UltimateHackingKeyboard/uhk60v2-electronics/README.md

Ultimate Hacking Keyboard electronics
=====================================

Contained are the schematics and board layout KiCad files for the [Ultimate Hacking Keyboard](https://ultimatehackingkeyboard.com/), the UHK 60 v2 in specific.

Please make sure to clone this repo with:

`git clone --recursive git@github.com:UltimateHackingKeyboard/uhk60v2-electronics.git`

Now, you should be able to open any of the [KiCad](http://kicad-pcb.org/) projects of the repo:

* [left-main](left-main) contains main PCB of left keyboard half.
* [right-main](right-main) contains the main PCB of the right keyboard half.
* [display](display) contains the PCB that interfaces our custom manufactured LED segment display with the left main PCB.
