UltimateHackingKeyboard/uhk60v2-electronics/right-main/right-main.pdf

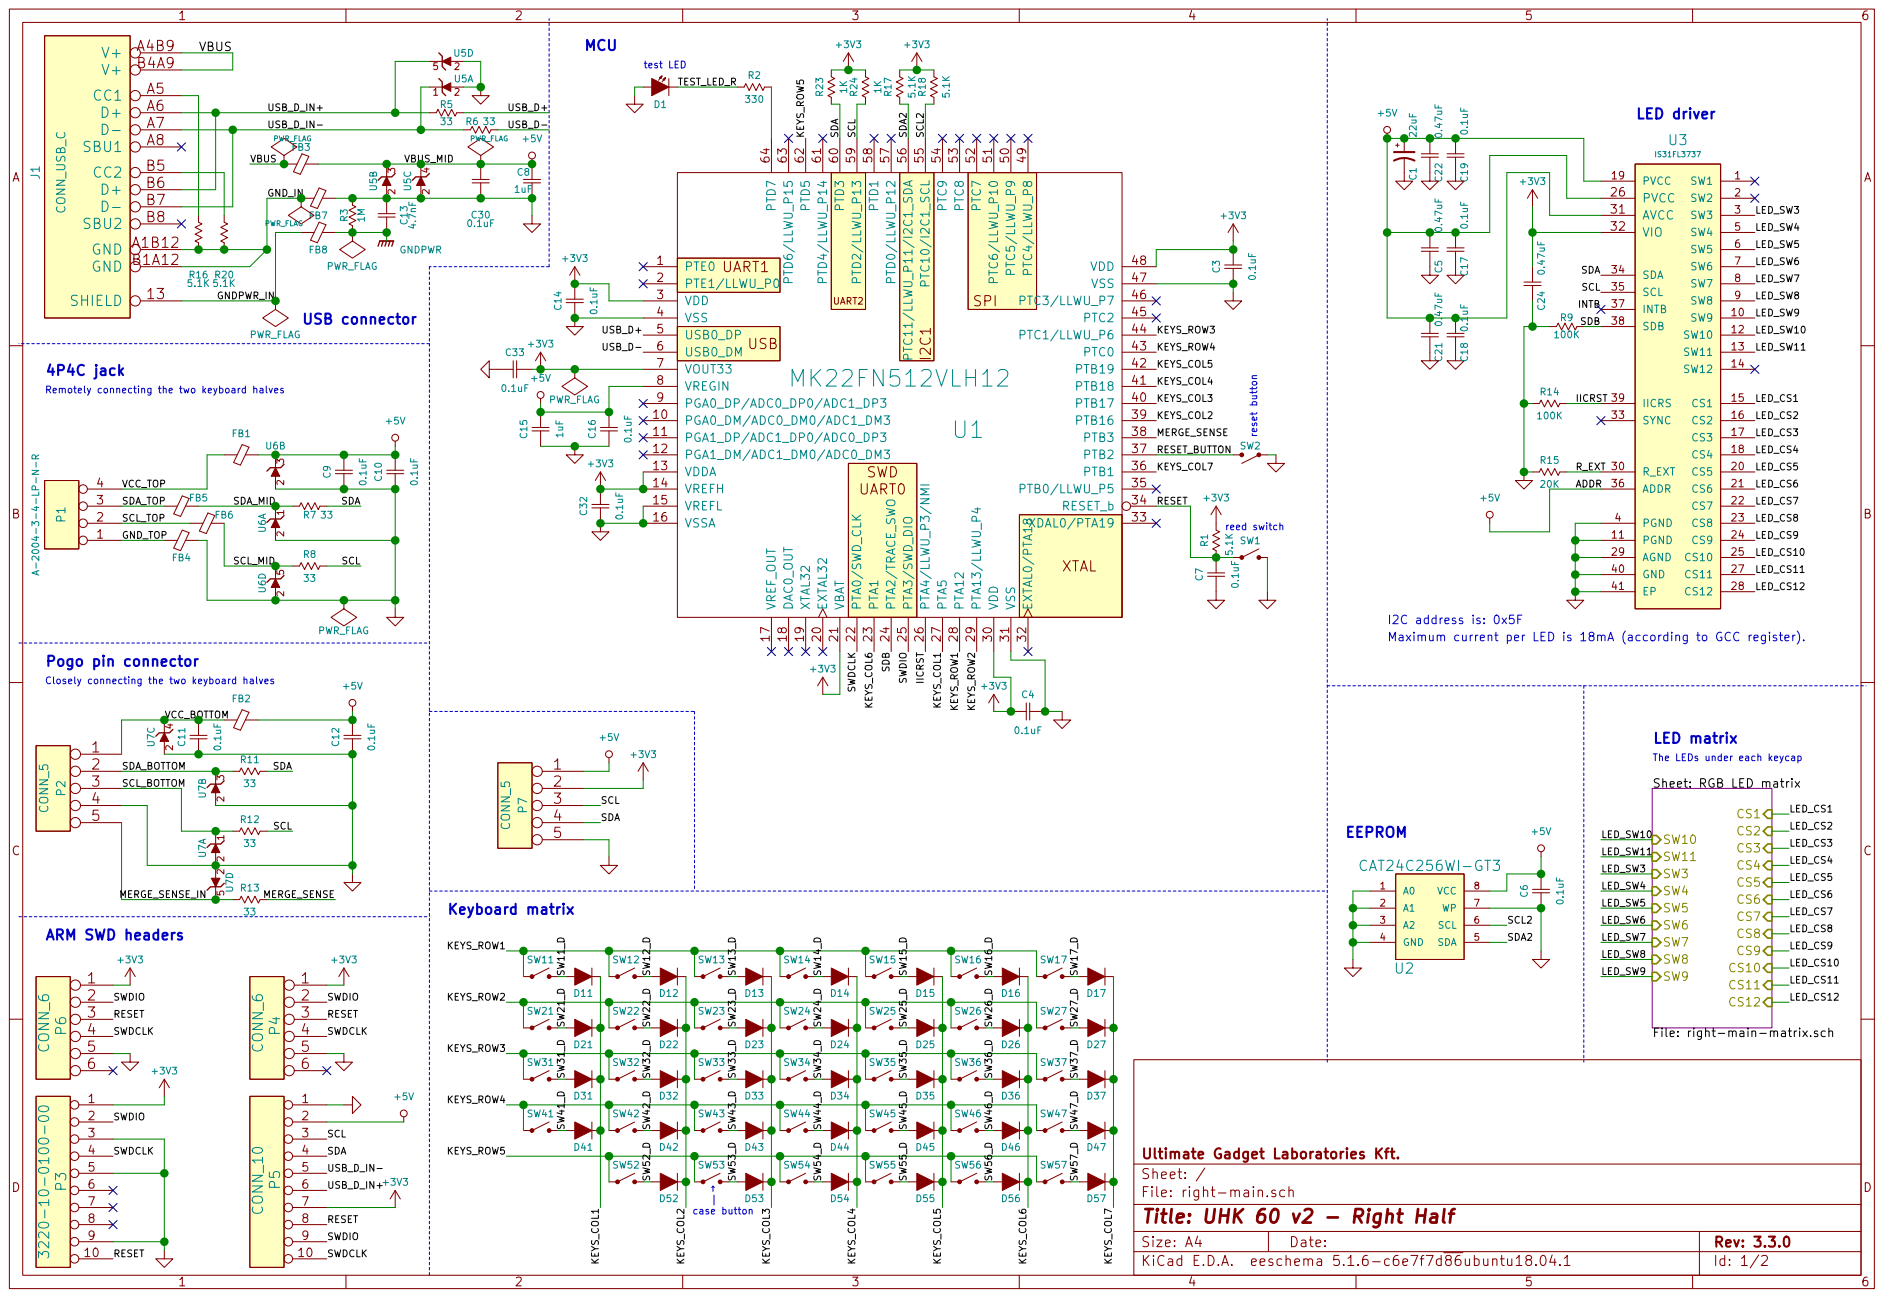
[picture p1: page 1]

The LEDs under each keycap MCU

LED driver LED matrix Maximum current per LED is 18mA (according to GCC register).

Closely connecting the two keyboard halves 4P4C jack

Id: 1/2 Title: UHK 60 v2 - Right Half
