UltimateHackingKeyboard/uhk60v2-electronics/left-main/left-main.pdf

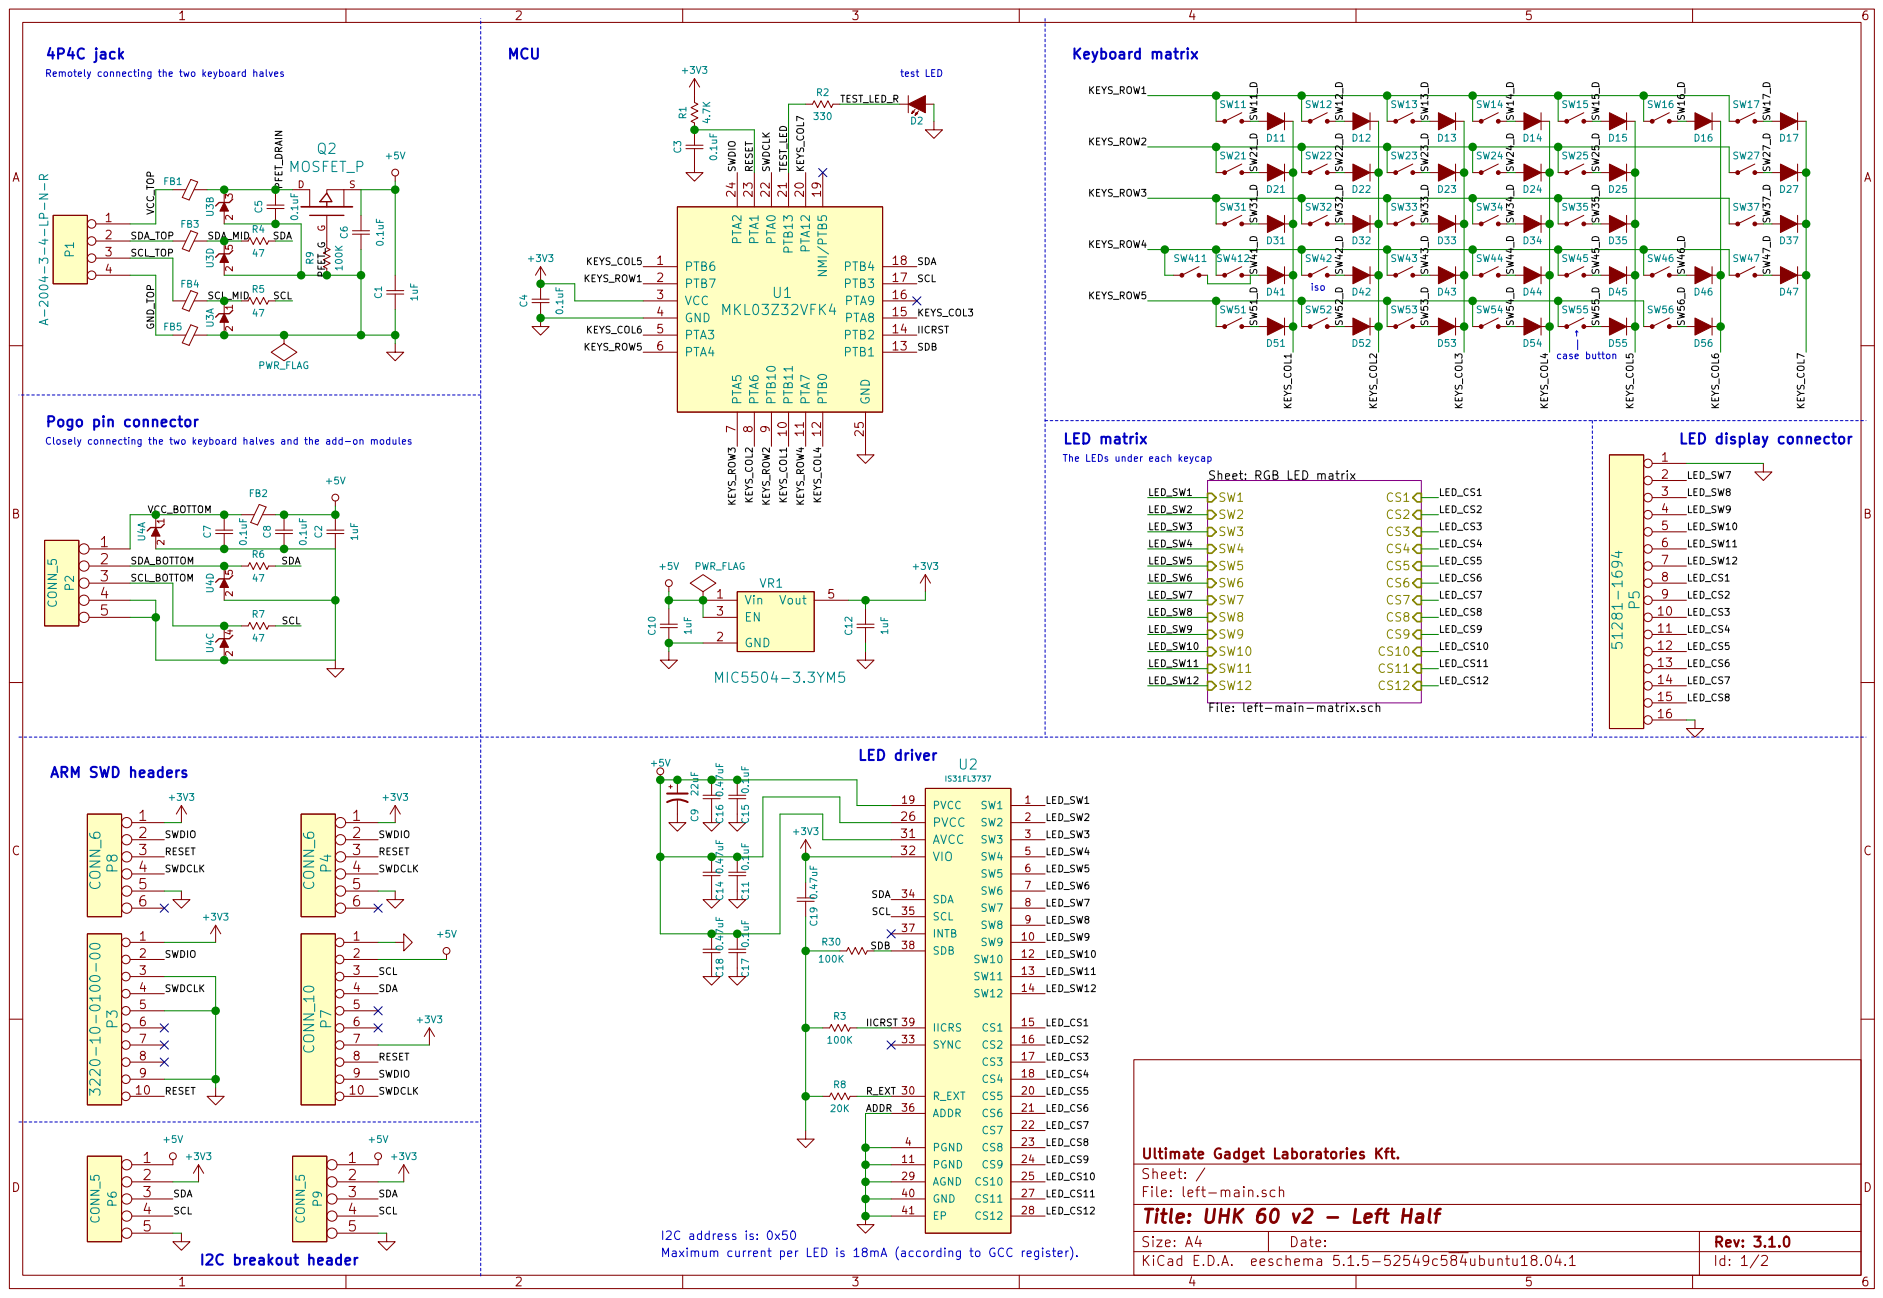
[picture p2: page 1]

The LEDs under each keycap MCU

iso Maximum current per LED is 18mA (according to GCC register). I2C breakout header

Id: 1/2 Title: UHK 60 v2 - Left Half File: left-main.sch Sheet: / Ultimate Gadget Laboratories Kft.
