UltimateHackingKeyboard/uhk60v2-electronics/(commit log)

2018-09-06 Update the submodule URL of the ugl-kicad-lib repo.
2018-09-06 Refer to the latest revision of ugl-kicad-lib.
2018-09-06 Add left-main-matrix.sch and update left-main.sch
    [left-main-matrix.sch]
2018-09-07 Change MX buttons to socket.
    [left-main-matrix.sch, left-main.sch]
2018-09-07 Change MX buttons to sockets on right side too.
    [right-main.sch]
2018-09-07 Add RGB LED matrix to right side.
    [right-main-matrix.sch, right-main.sch]
2018-09-07 Change LED driver to IS31FL3737.
    [right-main.sch]
2018-09-07 Change USB connector to USB type C.
    [right-main.sch]
2018-09-07 Set I2C address of LED driver.
    [left-main.sch, right-main.sch]
2018-09-07 Set footprints of RGB leds on both sides.
    [left-main-matrix.sch, right-main-matrix.sch]
2018-09-22 Add mandatory layers.
    [display.kicad_pcb, left-main.kicad_pcb, right-main.kicad_pcb]
2018-09-22 Update left board contour.
    [left-main.kicad_pcb]
2018-09-22 Update the contour of the right board.
    [right-main.kicad_pcb]
2018-09-22 Update the keepout areas of the left board.
    [left-main.kicad_pcb]
2018-09-22 Update the keepout areas of the right board.
    [right-main.kicad_pcb]
2018-09-22 Add circles to mark the positions of the LEDs of the left board.
    [left-main.kicad_pcb]
2018-09-22 Add circles to mark the positions of the LEDs of the right board.
    [right-main.kicad_pcb]
2018-09-22 Remove the top screw hole and related silk screen on the left and right boards.
    [left-main.kicad_pcb, right-main.kicad_pcb]
2018-09-22 Reposition the USB connector.
    [right-main.kicad_pcb]
2018-10-12 Fix schematic errors (error checker) on left side.
    [left-main-matrix.sch, left-main.sch]
2018-10-12 Update pcb with new components and set new positions of LEDs.
    [left-main.kicad_pcb]
2018-10-12 Update P7 swd header on left side.
    [left-main.sch]
2018-10-12 Revert "Update P7 swd header on left side."
    This reverts commit f23190d8810373420e60e62817cb1d523171376d.
    [left-main.sch]
2018-10-17 Change footprint of buttons to new hybrid type.
    [left-main.sch]
2018-10-17 Add footprint to LED driver and programming header, PCB update.
    [left-main.kicad_pcb, left-main.sch]
2018-10-17 The footprints of special buttons modified.
    [left-main.sch]
2018-10-17 Footprints position settings and a little wiring on left side.
    [left-main.kicad_pcb]
2018-10-19 Sockets repositioned.
    [left-main.kicad_pcb]
2018-10-26 Wiring on left side.
    [left-main.kicad_pcb, left-main.sch]
2018-10-28 Remove PWM test point from left side schematic.
    [left-main.sch]
2018-10-28 Change LED positions in matrix on left side.
    [left-main-matrix.sch]
2018-11-01 LED matrix pin order changed. PCB wiring on left side.
    [left-main-matrix.sch, left-main.kicad_pcb, left-main.sch]
2018-11-06 Change LED positions in matrix on left side and wiring on pcb.
    [left-main-matrix.sch, left-main.kicad_pcb]
2018-11-23 Remove capacitors. (Left)
    [left-main.sch]
2018-11-23 Rename testpoints and nets.
    [left-main.sch]
2018-11-23 Wiring on left side and fix silkscreen positions.
    [left-main.kicad_pcb]
2018-11-23 First final version of left side pcb.
    [left-main.kicad_pcb]
2018-11-27 Add power flag to +3V3.
    [left-main.sch]
2018-11-27 PCB check. (everything ok)
    [left-main.kicad_pcb]
2018-11-27 Mod. page settings parameters on sch. and pcb (version numbers, titles).
    [left-main-matrix.sch, left-main.kicad_pcb, left-main.sch]
2018-11-28 Remove DNP capacitors. Change LED driver net names.
    [left-main.sch]
2018-11-28 Change positions of designator on Silkscreen. Repos. FID3. Remove DNP caps.
    [left-main.kicad_pcb]
2018-12-03 Set footprints on right side schematic. (led driver, usb c)
    [right-main.sch]
2018-12-03 Update right side pcb according to schematic.
    [right-main.kicad_pcb]
2018-12-03 New type of pogo pin on left side.
    [left-main.kicad_pcb, left-main.sch]
2018-12-04 Add missing net names on left side.
    [left-main.kicad_pcb, left-main.sch]
2018-12-04 Necessary schematic modifications on right side.
    [right-main.sch]
2018-12-04 Refresh pcb with new footprints. Positions of new type of LEDs changed.
    [right-main.kicad_pcb]
2018-12-04 Set USB_C position.
    [right-main.kicad_pcb]
2018-12-10 Change socket footprints to hybrid type.
    [right-main.sch]
2018-12-10 Positions of RGB LEDs in matrix changed.
    [right-main-matrix.sch]
2018-12-10 Wiring on right side.
    [right-main.kicad_pcb]
2018-12-14 Reposition LEDs in matrix.
    [right-main-matrix.sch]
2018-12-14 Change driving lines of LED matrix.
    [right-main-matrix.sch, right-main.sch]
2018-12-14 Remove capacitor.
    [right-main.sch]
2018-12-14 Wiring on right side. (All connections are complete.)
    [right-main.kicad_pcb]
2018-12-16 Rotate D147 on right side.
    [right-main.kicad_pcb]
2018-12-16 10mm GND pad placed on left side pcb near UHK logo.
    [left-main.kicad_pcb]
2018-12-17 Update PCB with new 10mm GND pad footprint.
    [left-main.kicad_pcb]
2018-12-17 Add special socket footprint to button 7 on right side.
    [right-main.kicad_pcb, right-main.sch]
2018-12-17 Add fiducials on right side.
    [right-main.kicad_pcb]
2018-12-17 First final version of right side pcb.
    [right-main.kicad_pcb]
2018-12-18 Reposition tag connect on right side.
    [left-main.kicad_pcb, right-main.kicad_pcb]
2018-12-18 Channge tag connect position on left side pcb.
    [left-main.kicad_pcb]
2018-12-18 Optimized I2C paths on right side.
    [right-main.kicad_pcb]
2018-12-19 Fix FFC connector type in schematic on left side.
    [left-main.sch]
2018-12-19 New display board (update schematic and pcb).
    [display.kicad_pcb, display.sch]
2018-12-19 Wired display board.
    [display.kicad_pcb, display.sch]
2018-12-19 Add GND plane on display pcb.
    [display.kicad_pcb]
2018-12-19 Extended GND plane on right side pcb.
    [right-main.kicad_pcb]
2018-12-20 Update pogo connectors.
    [left-main.kicad_pcb, left-main.sch, right-main.kicad_pcb, right-main.sch]
2018-12-20 Fix errors. Add missing GND pad on left side. Displacement fiducial on right side.
    [left-main.kicad_pcb, right-main.kicad_pcb]
2018-12-20 DRC error fixed on display board.
    [display.kicad_pcb]
2018-12-30 USB C errors are solved. (Symbol, footprint, schematic, pcb)
    [right-main.kicad_pcb, right-main.sch]
2018-12-30 Collisions removed between test points and socket (left and right pcb).
    [left-main.kicad_pcb, right-main.kicad_pcb]
2018-12-30 Collisions removed between designator (silkscreen) and vias/pads.
    [left-main.kicad_pcb, right-main.kicad_pcb]
2018-12-30 Position of tag-connect changed.
    [left-main.kicad_pcb]
2018-12-30 Display FFC pinout changed.
    [display.kicad_pcb, display.sch, left-main.kicad_pcb, left-main.sch]
2019-01-13 Updated Cmts.User layers on left and right pcb.
    [left-main.kicad_pcb, right-main.kicad_pcb]
2019-01-14 Modified wiring on right side (panelize)
    [right-main.kicad_pcb]
2019-01-28 Change values of R23 and R24 to 1k on right side.
    [right-main.sch]
2019-01-28 Place text and logo onto silkscreen layer.
    [left-main.kicad_pcb, right-main.kicad_pcb]
2019-01-28 Change footrpints of 0.1uF capacitors to 0603.
    [left-main.kicad_pcb, left-main.sch, right-main.kicad_pcb, right-main.sch]
2019-01-30 Add 2x3 tag connectors to both side.
    [left-main.kicad_pcb, left-main.sch, right-main.kicad_pcb, right-main.sch]
2019-01-30 Flip USB C connector to the back side of right board.
    [right-main.kicad_pcb]
2019-02-08 Modified wiring on left side (panelize)
    [left-main.kicad_pcb]
2019-02-19 Recommended parts of LED driver added on left side.
    [left-main.kicad_pcb, left-main.sch]
2019-02-19 Recommended parts of LED driver added on right side.
    [left-main.kicad_pcb, right-main.kicad_pcb, right-main.sch]
2019-02-19 Updated footprints on both side (silkscreen mods).
    [left-main.kicad_pcb, right-main.kicad_pcb]
2019-02-19 Recommended parts of LED driver added on both side (0.47uF).
    [left-main.kicad_pcb, left-main.sch, right-main.kicad_pcb, right-main.sch]
2019-02-26 Reposition bridges.
    [right-main.kicad_pcb]
2019-03-05 Library update. Updated silkscreen layers on both sides.
    [left-main.kicad_pcb, right-main.kicad_pcb]
2019-03-10 Library update and use new footprints on boards. Wiring on left side.
    [left-main.sch, right-main.kicad_pcb]
2019-03-12 Remove some DRC errors.
    [left-main.kicad_pcb]
2019-03-22 Wiring on left side (almost complete).
    [left-main.kicad_pcb]
2019-03-22 Zone update on left side.
    [left-main.kicad_pcb]
2019-03-22 Add resistors to USB-C section.
    [right-main.sch]
2019-03-22 Update footprints, edge cuts and keepout (Eco1) layers on right side.
    [right-main.kicad_pcb]
2019-03-22 Add new margin layer to right side.
    [right-main.kicad_pcb]
2019-03-26 Rotated sockets and LEDs on right side.
    [right-main.kicad_pcb]
2019-04-09 Change footprint of button 7 on right side.
    [right-main.sch]
2019-04-09 Change footprint of USB C resistors.
    [right-main.sch]
2019-04-09 Completed wiring on right side.
    [right-main.kicad_pcb]
2019-04-09 Update EEPROM footprint on right side.
    [right-main.kicad_pcb]
2019-04-09 New voltage regulator on left side.
    [left-main.kicad_pcb, left-main.sch]
2019-04-09 5 pin ffc on left side added.
    [left-main.kicad_pcb, left-main.sch]
2019-04-09 Wiring on right side. New ffc added.
    [right-main.kicad_pcb, right-main.sch]
2019-04-12 USB lines are connected to repositioned JTAG connector.
    [right-main.kicad_pcb, right-main.sch]
2019-04-12 Updated socket footprints on both sides.
    [left-main.kicad_pcb, right-main.kicad_pcb]
2019-04-12 ERC fix on left schematic.
    [left-main.sch]
2019-04-12 Use dedicated footprint on right side near FFC connector (collision).
    [right-main.sch]
2019-04-12 Completed silkscreen layers.
    [left-main.kicad_pcb, right-main.kicad_pcb]
2019-04-14 Library update (TH footprints)
    [display.kicad_pcb, left-main.kicad_pcb, right-main.kicad_pcb]
2019-04-14 Wiring on right side. (panelizer)
    [right-main.kicad_pcb]
2019-04-14 Wiring on left side. (panelizer)
    [left-main.kicad_pcb]
2019-04-14 Modified outline bridges on left side.
    [left-main.kicad_pcb]
2019-04-15 Outline bridges removed from display board.
    [display.kicad_pcb]
2019-04-15 Add readme for the pogo pin min distance script.
2019-04-15 Edit B.Paste layers.
    [left-main.kicad_pcb, right-main.kicad_pcb]
2019-04-16 Updated Edge.Cuts layers on both side.
    [left-main.kicad_pcb, right-main.kicad_pcb]
2019-04-25 Increased power tracks on left and right pcb.
    [left-main.kicad_pcb, right-main.kicad_pcb]
2019-04-26 LED driver Vccio changed.
    [left-main.kicad_pcb, left-main.sch, right-main.kicad_pcb, right-main.sch]
2019-05-03 LED driver connections changed.
    [left-main.kicad_pcb, left-main.sch, right-main.kicad_pcb, right-main.sch]
2019-05-05 Add front-side RGB LED silk screen for showing orientation.
    [left-main.kicad_pcb, right-main.kicad_pcb]
2019-05-05 Improve silk screen.
    [display.kicad_pcb, display.sch, left-main.kicad_pcb, left-main.sch, right-main.kicad_pcb, right-main.sch]
2019-05-05 Update pogo pin footprints and improve silk screen.
    [display.kicad_pcb, left-main.kicad_pcb, right-main.kicad_pcb]
2019-05-05 Improve silk screen and move around test points.
    [display.kicad_pcb, left-main.kicad_pcb, right-main.kicad_pcb]
2019-05-05 Update silk screen and adjust test point positions.
    [left-main.kicad_pcb, right-main.kicad_pcb]
2019-05-05 Improve silk screen and adjust test point positions.
    [left-main.kicad_pcb, right-main.kicad_pcb]
2019-05-06 Modified tracks on bridges.
    [left-main.kicad_pcb, right-main.kicad_pcb]
2019-05-07 Track width decreased on bridges.
    [left-main.kicad_pcb, right-main.kicad_pcb]
2019-05-14 Make fiducials, reed switches and programming headers virtual.
    [display.kicad_pcb, left-main.kicad_pcb, right-main.kicad_pcb]
2019-05-14 Make test LED parts virtual.
    [left-main.kicad_pcb, right-main.kicad_pcb]
2019-05-14 Set the value of D111 to VAL**, just like all the other SMD RGB LEDs.
    [right-main.kicad_pcb]
2019-05-14 Mark unused 10uF caps virtual.
    [left-main.kicad_pcb, right-main.kicad_pcb]
2019-05-15 Make the "Model: UHK 60 v2 | PCB ID: uhk60v2_left_2.0.0" text slightly larger.
    [left-main.kicad_pcb]
2019-07-15 Modify tag connect pinout on both side.
    [left-main.kicad_pcb, left-main.sch, right-main.kicad_pcb, right-main.sch]
2019-08-06 Update rgb led footprints and remove unneccessary components.
    [left-main.kicad_pcb, right-main.kicad_pcb, right-main.sch]
2019-08-06 Change orientation of sockets.
    [left-main.kicad_pcb, right-main.kicad_pcb]
2019-08-06 Rotate rgb leds.
    [left-main.kicad_pcb]
2019-08-06 Update pcbs with modified rgb led footrpint.
    [left-main.kicad_pcb, right-main.kicad_pcb]
2019-08-06 Fix contour on both pcb.
    [left-main.kicad_pcb, right-main.kicad_pcb]
2019-08-06 Remove ADC circuit on right side.
    [right-main.kicad_pcb, right-main.sch]
2019-08-07 Ignore generated BOM. Update UGL lib.
2019-08-09 Update right FFC connector footprint.
    [right-main.kicad_pcb]
2019-08-09 Update FFC connectors. Resolve DRC errors.
    [left-main.kicad_pcb]
2019-08-10 Remove the shield ring from the right half as it can't be placed.
    [right-main-matrix.sch, right-main.kicad_pcb, right-main.sch]
2019-08-10 Resolve DRC errors by not crossing board edges with tracks.
    [left-main.kicad_pcb, right-main.kicad_pcb]
2019-08-10 Put the RGB LED footprints of the right half to the bottom side.
    [right-main-matrix.sch, right-main.kicad_pcb]
2019-08-10 Put the RGB LEDs of the left half on the bottom side.
    [left-main.kicad_pcb]
2019-08-10 Update RGB LED values.
    [left-main.kicad_pcb]
2019-08-10 Remove margin layer artifacts.
    [left-main.kicad_pcb, right-main.kicad_pcb]
2019-08-11 Update contours and library reference.
    [left-main.kicad_pcb, right-main.kicad_pcb]
2019-08-11 Change 0805 footrpints to 0603.
    [left-main.kicad_pcb, left-main.sch, right-main.kicad_pcb, right-main.sch]
2019-08-11 Visible values on silkscreen layers.
    [left-main.kicad_pcb, left-main.sch, right-main.kicad_pcb, right-main.sch]
2019-08-11 Change bridge position on right pcb.
    [right-main.kicad_pcb]
2019-08-12 Update LED footprints.
    [left-main.kicad_pcb, right-main.kicad_pcb]
2019-08-13 Remove test points.
    [display.kicad_pcb, display.sch, left-main-matrix.sch, left-main.kicad_pcb, left-main.sch, right-main.kicad_pcb, right-main.sch]
2019-08-13 Revert test point changes.
    [display.kicad_pcb, display.sch, left-main-matrix.sch, left-main.kicad_pcb, left-main.sch, right-main.kicad_pcb, right-main.sch]
2019-08-14 Fix right half contour.
    [right-main.kicad_pcb]
2019-08-14 Fix left half contour.
    [left-main.kicad_pcb]
2019-08-14 Remove connector boards.
    [connectors.kicad_pcb, connectors.sch]
2019-08-14 Add key labels on the right half as text items.
    [right-main.kicad_pcb]
2019-08-14 Put socket modules to the back side on the right half.
    [right-main.kicad_pcb]
2019-08-14 Change socket values to S01_Socket.
    [right-main.kicad_pcb, right-main.sch]
2019-08-15 Adjust the positioning of hidden values and unhide some of them on the right half.
    [right-main.kicad_pcb]
2019-08-15 Improve the silk screen of the right half.
    [right-main.kicad_pcb]
2019-08-15 Improve right half silk screen.
    [right-main.kicad_pcb]
2019-08-15 Add UHK logos on the left and right halves.
    [left-main.kicad_pcb, right-main.kicad_pcb]
2019-08-16 Make pogo pin connectors through-hole and make logos virtual.
    [left-main.kicad_pcb, right-main.kicad_pcb]
2019-08-17 Update a bunch of components to remove their technical silk screen layers.
    [left-main.kicad_pcb, right-main.kicad_pcb]
2019-08-17 Update components to remove technical silk screen layers.
    [right-main.kicad_pcb]
2019-08-17 Update components to remove silk screen from technical layers.
    [left-main.kicad_pcb]
2019-08-17 Add front facing silk sceen text for the key letters of the right half.
    [right-main.kicad_pcb]
2019-08-17 Add separate key texts on the back side of the left board.
    [left-main.kicad_pcb]
2019-08-17 Reposition the FFC connector of the display board.
    [display.kicad_pcb]
2019-08-17 Interconnect display GND pads.
    [display.kicad_pcb]
2019-08-17 Update silk screen.
    [display.kicad_pcb]
2019-08-17 Reposition the FFC connector of the LED display on the left board.
    [left-main.kicad_pcb]
2019-08-17 Adjust tracks a bit.
    [left-main.kicad_pcb]
2019-08-17 Update and flip S01_Hybrid_Socket modules.
    [left-main.kicad_pcb]
2019-08-17 Change left side socket values to S01_Socket.
    [left-main.kicad_pcb, left-main.sch]
2019-08-18 Update S01_Hybrid_Socket_Left_Pin and S01_Hybrid_Socket_Right_Pin modules.
    [left-main.kicad_pcb]
2019-08-18 Update S01_Hybrid_Socket_ANSI_Shift_InverseSlotHole.
    [left-main.kicad_pcb]
2019-08-18 Update switch values of the left half.
    [left-main.kicad_pcb, right-main.kicad_pcb]
2019-08-18 Reposition S01_Socket and RGB_LED hidden values.
    [left-main.kicad_pcb]
2019-08-18 Flip SW* reference designators on the left half.
    [left-main.kicad_pcb]
2019-08-18 Reposition SW* and D* reference designators on the left half.
    [left-main.kicad_pcb]
2019-08-19 Add front side key texts for the left half.
    [left-main.kicad_pcb]
2019-08-19 Adjust font thicknesses.
    [left-main.kicad_pcb]
2019-08-19 Replace SOD-123 diodes with SOD-323 on the left half.
    [left-main.kicad_pcb, left-main.sch]
2019-08-19 Fix tracks now that the SOD-323 diodes have been placed.
    [left-main.kicad_pcb]
2019-08-19 Fix most of the routing for SOD-323 on the right half.
    [right-main.kicad_pcb, right-main.sch]
2019-08-19 Improve SOD-323 related rerouting on the right half.
    [right-main.kicad_pcb]
2019-08-19 Make DRC happy on the right half after the SOD-323 change.
    [right-main.kicad_pcb]
2019-08-19 Route 3 of the 4 D1411 tracks.
    [left-main-matrix.sch, left-main.kicad_pcb]
2019-08-19 Fully route tracks to D1411.
    [left-main.kicad_pcb]
2019-08-19 Connect ground all the way on the left half.
    [left-main.kicad_pcb]
2019-08-19 Replace 0806 test LEDs with 0603.
    [left-main.kicad_pcb, left-main.sch, right-main.kicad_pcb, right-main.sch]
2019-08-19 Improve silk screen on the right half.
    [right-main.kicad_pcb]
2019-08-20 Make test LEDs and their resistors virtual.
    [left-main.kicad_pcb, right-main.kicad_pcb]
2019-08-22 Put C11 and C14 much closer to the LED driver.
    [left-main.kicad_pcb]
2019-08-23 Exchange C11 and C14.
    [left-main.kicad_pcb]
2019-08-23 Remove fiducials.
    [left-main.kicad_pcb, right-main.kicad_pcb]
2019-08-23 Place C15 closer to the LED driver. Don't connect INTB on the left half.
    [left-main.kicad_pcb, left-main.sch]
2019-08-23 Put C16 closer to the LED driver.
    [left-main.kicad_pcb]
2019-08-23 Route caps closer to the LED driver.
    [left-main.kicad_pcb]
2019-08-23 Don't connect INTB on the right half either.
    [right-main.kicad_pcb, right-main.sch]
2019-08-24 Update left board outline based on CAD.
    [left-main.kicad_pcb]
2019-08-24 Update right board edge based on CAD.
    [right-main.kicad_pcb]
2019-08-24 Update the keepout areas of the right half.
    [right-main.kicad_pcb]
2019-08-24 Update left board keepout areas.
    [left-main.kicad_pcb]
2019-08-24 Move tracks farther from the edge.
    [display.kicad_pcb]
2019-08-24 Route outbound tracks as close as possible to breakout tabs.
    [left-main.kicad_pcb, right-main.kicad_pcb]
2019-08-24 Put tracks farther from the edge of the right board.
    [right-main.kicad_pcb]
2019-08-24 Route tracks farther from the edges on the left half.
    [left-main.kicad_pcb]
2019-08-24 Bump version number to 3.0.0
    [display.kicad_pcb, display.sch, left-main.kicad_pcb, left-main.sch, right-main.kicad_pcb, right-main.sch]
2019-08-24 Change version number on boards to 3.0.0
    [display.kicad_pcb, left-main.kicad_pcb, right-main.kicad_pcb]
2019-08-24 Rotate every LED in 180 degree orientation which can be rotated as such.
    [left-main.kicad_pcb, right-main.kicad_pcb]
2019-08-24 Move things out of the way of the keepout zones of the feet.
    [left-main.kicad_pcb, left-main.sch, right-main.kicad_pcb]
2019-08-25 Make the ground pour zones of the boards closely follow their outlines.
    [display.kicad_pcb, left-main.kicad_pcb, right-main.kicad_pcb]
2019-08-30 Change bayonet lock soft keepout area depths from 0.9 to 1.4 mm.
    [left-main.kicad_pcb, right-main.kicad_pcb]
2019-08-31 Add cutout above SW25 that must have been removed accidentally.
    [right-main.kicad_pcb]
2019-08-31 Put C4 closer to U1.
    [left-main.kicad_pcb]
2019-08-31 Don't put solder paste on the pads of the test LED regions.
    [left-main.kicad_pcb, right-main.kicad_pcb]
2019-08-31 Remove C13 from the left side.
    [left-main.kicad_pcb, left-main.sch]
2019-08-31 Remove C20 and C2 from the right half.
    [right-main.kicad_pcb, right-main.sch]
2019-08-31 Change the capacitance of tantalum caps from 10uF to 22uF.
    [left-main.kicad_pcb, left-main.sch, right-main.kicad_pcb, right-main.sch]
2019-08-31 Place C10 and C12 closer to VR1.
    [left-main.kicad_pcb]
2019-08-31 Put C20 closer to U2.
    [left-main.kicad_pcb]
2019-08-31 Clean up tracks.
    [left-main.kicad_pcb]
2019-08-31 Put C3 and R1 closer to U1.
    [left-main.kicad_pcb]
2019-08-31 Put R9 closer to the 4P4C block.
    [left-main.kicad_pcb]
2019-08-31 Place R1 and C3 a bit farther from D15.
    [left-main.kicad_pcb]
2019-08-31 Put components closer to the pogo pin connector.
    [left-main.kicad_pcb]
2019-08-31 Tweak silk screen.
    [left-main.kicad_pcb]
2019-08-31 Put C14, C15, C16, C33 closer to U1.
    [right-main.kicad_pcb]
2019-08-31 Put R5 and R6 closer to U1 and connect USB_D_IN[+-] to P5 instead of USB_D[+-].
    [right-main.kicad_pcb, right-main.sch]
2019-08-31 Put C6 closer to U2.
    [right-main.kicad_pcb]
2019-09-01 Move texts so that they don't interfere with other boards on the panel.
    [display.kicad_pcb, left-main.kicad_pcb, right-main.kicad_pcb]
2019-09-01 Add comma.
    [right-main.kicad_pcb]
2019-09-01 Update LED display module.
    [display.kicad_pcb]
2019-09-03 Fix the positions of pogo pin connectors.
    [left-main.kicad_pcb, right-main.kicad_pcb]
2019-10-29 Update diode and RGB LED modules.
    [left-main.kicad_pcb, right-main.kicad_pcb]
2019-10-29 Update keepout areas based on CAD.
    [right-main.kicad_pcb]
2019-10-29 Update right half contour according to CAD.
    [right-main.kicad_pcb]
2019-10-29 Update the ground pour of the right half according to the udpated contour.
    [right-main.kicad_pcb]
2019-10-30 Fix boss side position.
    [left-main.kicad_pcb]
2019-10-30 Update the keepout area of the left half based on CAD.
    [left-main.kicad_pcb]
2019-10-30 Update left contour based on CAD.
    [left-main.kicad_pcb]
2019-10-30 Update the zone of the left half based on the new contour.
    [left-main.kicad_pcb]
2019-10-31 Update the sockets of the 1st row of the right half.
    [right-main.kicad_pcb]
2019-10-31 Update sockets in the 2nd row of the right half.
    [right-main.kicad_pcb]
2019-10-31 Update the sockets of the 3rd row of the right half.
    [right-main.kicad_pcb]
2019-11-01 Update the sockets of the 4th row of the right half.
    [right-main.kicad_pcb]
2019-11-01 Update the sockets of the 5th row of the right half.
    [right-main.kicad_pcb]
2019-11-01 Fix the positions of the reference designators of the right half.
    [right-main.kicad_pcb]
2019-11-01 Move TC2060 header slightly farther from the pad of the nearby socket.
    [right-main.kicad_pcb]
2019-11-01 Make edge layer continuous. Update SW11 socket.
    [left-main.kicad_pcb]
2019-11-01 Update more sockets in the 1st row of the left UHK half.
    [left-main.kicad_pcb]
2019-11-01 Update most sockets in the 1st row of the left half except 2.
    [left-main.kicad_pcb]
2019-11-01 Update the sockets of the 2nd row of the left keyboard half.
    [left-main.kicad_pcb]
2019-11-02 Change the last switch of the 2nd row of the left half.
    [left-main.kicad_pcb]
2019-11-02 Change the sockets of the 3rd row of the left half.
    [left-main.kicad_pcb]
2019-11-02 Replace sockets of the 4th row of the left half with the exception of ANSI and ISO sockets.
    [left-main.kicad_pcb]
2019-11-02 Replace 3 sockets of the 5th row of the left half.
    [left-main.kicad_pcb]
2019-11-02 Replace one more socket in the 5th row of the left half.
    [left-main.kicad_pcb]
2019-11-02 Connect unconnected nets.
    [left-main.kicad_pcb]
2019-11-02 Change the last socket of the 5th row of the left half.
    [left-main.kicad_pcb]
2019-11-13 Update the SW12 socket.
    [left-main.kicad_pcb]
2019-11-13 Update SW13 socket.
    [left-main.kicad_pcb]
2019-11-13 Put the 22uF cap closer to the LED driver.
    [left-main.kicad_pcb]
2019-11-20 Update Omron switch modules.
    [left-main.kicad_pcb, right-main.kicad_pcb]
2019-11-20 Use the new left ISO socket module.
    [left-main.kicad_pcb]
2019-11-20 Update middle ISO socket.
    [left-main.kicad_pcb]
2019-11-20 Update Left ISO socket.
    [left-main.kicad_pcb]
2019-11-20 Use ISO right socket.
    [left-main.kicad_pcb]
2019-11-26 Move C4 way closer to the 30 and 31 pins of U1.
    [right-main.kicad_pcb]
2019-11-26 Add 3.3V zone below U1.
    [right-main.kicad_pcb]
2019-11-26 Put C32 closer to U1 and put C23 closer to U3.
    [right-main.kicad_pcb]
2019-11-26 Route GNDPWR near the USB connector better.
    [right-main.kicad_pcb]
2019-11-26 Add ferrite for GNDPWR.
    [right-main-matrix.sch, right-main.kicad_pcb, right-main.sch]
2019-11-26 Put caps closer to pin 19 of U3.
    [right-main.kicad_pcb]
2019-11-26 Make the position of C1, C22 and C19 more explicit on the schematic.
    [right-main.kicad_pcb, right-main.sch]
2019-11-26 Clarify the position of C5 and C17 on the schematic.
    [right-main.kicad_pcb, right-main.sch]
2019-11-26 Improve the placement of C19.
    [right-main.kicad_pcb]
2019-11-26 Improve the placement of C22.
    [right-main.kicad_pcb]
2019-11-26 Put caps closer to U3.
    [right-main.kicad_pcb, right-main.sch]
2019-11-26 Connect every net.
    [right-main.kicad_pcb]
2019-11-26 Put C14 closer to the U1.
    [right-main.kicad_pcb]
2019-11-26 Restore the position of C14 because it's contrained by keepout areas.
    [right-main.kicad_pcb]
2019-11-26 Import netlist.
    [right-main.kicad_pcb]
2019-11-26 Bring components closer to U3.
    [right-main.kicad_pcb]
2019-11-26 Simplify the routing of the 5V rail near the LED driver.
    [right-main.kicad_pcb]
2019-11-26 Simplify 5V rail routing.
    [right-main.kicad_pcb]
2019-11-26 Make schematics less crowded.
    [left-main-matrix.sch, left-main.sch, right-main.sch]
2019-11-27 Simplify the 5V rail of the right half which leads to the EEPROM and MCU.
    [right-main.kicad_pcb]
2019-11-27 Move U3 downward farther from keepout areas.
    [right-main.kicad_pcb]
2019-11-27 Update netlist to feature the correct ISO switch modules.
    [left-main.sch]
2019-11-27 Update left board based on netlist.
    [left-main.kicad_pcb]
2019-11-27 Update right board based on netlist.
    [right-main.kicad_pcb]
2019-11-27 Remove C20 from the left half because it was not needed for the LED driver.
    [left-main.kicad_pcb, left-main.sch]
2019-11-27 Make the silk screen of the right half look great.
    [right-main.kicad_pcb]
2019-11-28 Fix silk screen positions.
    [left-main.kicad_pcb]
2019-11-28 Exchange C5 and C17.
    [right-main.kicad_pcb]
2019-11-28 Make the schematic of the left half show where the capacitors of the LED driver should be placed.
    [left-main.sch, right-main.kicad_pcb]
2019-12-04 Change R_EXT to 20K on both halves.
    [left-main.kicad_pcb, left-main.sch, right-main.kicad_pcb, right-main.sch]
2019-12-04 Slightly reposition C18 and C21 on the schematic.
    [right-main.sch]
2019-12-23 Fix the silk screen position for C18 and C21 on the right half.
    [right-main.kicad_pcb]
2019-12-23 Make the test LED and its resistor virtual on the left half.
    [left-main.kicad_pcb]
2019-12-23 Show reset pins on the back of the left and right boards.
    [left-main.kicad_pcb, right-main.kicad_pcb]
2019-12-23 Update some processors modules to make their orientation marker easier to see.
    [left-main.kicad_pcb, right-main.kicad_pcb]
2019-12-23 Change the silk screen text of the ISO key to ISO instead of \
    [left-main.kicad_pcb]
2019-12-23 Rotate key texts on the back side of the boards according to the angles of sockets.
    [left-main.kicad_pcb, right-main.kicad_pcb]
2019-12-23 Update FFC connector on the display board.
    [display.kicad_pcb]
2019-12-24 Reposition reference designator.
    [left-main.kicad_pcb]
2019-12-24 Make the silk screen of test LED sections nicer.
    [left-main.kicad_pcb, right-main.kicad_pcb]
2019-12-24 Move the test LED closer to the edge of the left board.
    [left-main.kicad_pcb]
2019-12-26 Update SS-01D switches to feature the pin plunger on the silk screen.
    [left-main.kicad_pcb, right-main.kicad_pcb]
2019-12-26 Put silk screen texts closer to their relevant sockets.
    [left-main.kicad_pcb, right-main.kicad_pcb]
2019-12-26 Change the orientation of P6.
    [right-main.kicad_pcb]
2019-12-26 Change the orientation and position of P5.
    [right-main.kicad_pcb]
2019-12-26 Bump version to 3.1.0
    [display.kicad_pcb, display.sch, left-main.kicad_pcb, left-main.sch, right-main.kicad_pcb, right-main.sch]
2019-12-26 Resolve ERC errors.
    [right-main.sch]
2019-12-26 Don't put paste on the pads of the test LED and its resistor.
    [left-main.kicad_pcb]
2019-12-28 Improve front silk screen key texts.
    [left-main.kicad_pcb, right-main.kicad_pcb]
2020-01-01 Correct TC2060 to TC2050 on both halves.
    [left-main.kicad_pcb, right-main.kicad_pcb]
2020-01-24 Change 4700pF to 4.7nF.
    [right-main.kicad_pcb, right-main.sch]
2020-03-05 Update right SW44 socket.
    [right-main.kicad_pcb]
2020-03-05 Update right SW45 socket.
    [right-main.kicad_pcb]
2020-03-05 Update right SW46 socket.
    [right-main.kicad_pcb]
2020-03-05 Update right SW47 socket.
    [right-main.kicad_pcb]
2020-03-05 Update right SW57 socket.
    [right-main.kicad_pcb]
2020-03-05 Update right SW43 socket.
    [right-main.kicad_pcb]
2020-03-05 Update right SW32 socket.
    [right-main.kicad_pcb]
2020-03-05 Update right SW33 socket.
    [right-main.kicad_pcb]
2020-03-05 Update right SW34 socket.
    [right-main.kicad_pcb]
2020-03-05 Update right SW35 socket.
    [right-main.kicad_pcb]
2020-03-05 Update right SW36 socket.
    [right-main.kicad_pcb]
2020-03-05 Update right SW25 socket.
    [right-main.kicad_pcb]
2020-03-05 Update right SW24 socket.
    [right-main.kicad_pcb]
2020-03-05 Update right SW23 socket.
    [right-main.kicad_pcb]
2020-03-05 Update right SW22 socket.
    [right-main.kicad_pcb]
2020-03-05 Update right SW21 socket.
    [right-main.kicad_pcb]
2020-03-05 Update right SW31 socket.
    [right-main.kicad_pcb]
2020-03-05 Update right SW11 socket.
    [right-main.kicad_pcb]
2020-03-05 Update right SW41 socket.
    [right-main.kicad_pcb]
2020-03-05 Update right SW42 socket.
    [right-main.kicad_pcb]
2020-03-06 Update right SW12 socket.
    [right-main.kicad_pcb]
2020-03-06 Update right SW13 and SW14 sockets.
    [right-main.kicad_pcb]
2020-03-06 Update right SW15 socket.
    [right-main.kicad_pcb]
2020-03-06 Update right SW16 socket.
    [right-main.kicad_pcb]
2020-03-06 Update right SW17 socket.
    [right-main.kicad_pcb]
2020-03-07 Update right SW55 socket.
    [right-main.kicad_pcb]
2020-03-07 Update right SW26 socket.
    [right-main.kicad_pcb]
2020-03-07 Update right SW37 socket.
    [right-main.kicad_pcb]
2020-03-08 Update right SW52 socket.
    [right-main.kicad_pcb]
2020-03-08 Update right inner sockets.
    [right-main.kicad_pcb]
2020-03-08 Change inner left sockets to S01_Hybrid_Socket_Inner_Left
    [left-main.kicad_pcb]
2020-03-08 Update inner left sockets.
    [left-main.kicad_pcb]
2020-03-09 Update ISO sockets.
    [left-main.kicad_pcb]
2020-03-09 Fix DRC error by updating the left ISO socket.
    [left-main.kicad_pcb]
2020-03-09 Update left SW52 socket.
    [left-main.kicad_pcb]
2020-03-09 Update left SW32 socket.
    [left-main.kicad_pcb]
2020-03-09 Update left SW31 socket.
    [left-main.kicad_pcb]
2020-03-09 Update left SW43 socket.
    [left-main.kicad_pcb]
2020-03-09 Update left SW44 socket.
    [left-main.kicad_pcb]
2020-03-09 Update left SW45 socket.
    [left-main.kicad_pcb]
2020-03-09 Update left SW33 socket.
    [left-main.kicad_pcb]
2020-03-09 Update left SW34 socket.
    [left-main.kicad_pcb]
2020-03-09 Update left SW35 socket.
    [left-main.kicad_pcb]
2020-03-09 Update left SW46 socket.
    [left-main.kicad_pcb]
2020-03-09 Optimize diode placement.
    [left-main.kicad_pcb]
2020-03-09 Update left SW56 socket.
    [left-main.kicad_pcb]
2020-03-09 Update left SW11 socket.
    [left-main.kicad_pcb]
2020-03-09 Update left SW51 socket.
    [left-main.kicad_pcb]
2020-03-09 Update left SW16 socket.
    [left-main.kicad_pcb]
2020-03-09 Update left SW21 socket.
    [left-main.kicad_pcb]
2020-03-09 Update left SW54 socket.
    [left-main.kicad_pcb]
2020-03-09 Update left SW53 socket.
    [left-main.kicad_pcb]
2020-03-09 Update left SW22 socket.
    [left-main.kicad_pcb]
2020-03-09 Update left SW23 socket.
    [left-main.kicad_pcb]
2020-03-09 Improve diode placement.
    [left-main.kicad_pcb]
2020-03-10 Improve the diode placement and silk screen of the first row of the right half.
    [right-main.kicad_pcb]
2020-03-10 Update left SW25 socket.
    [left-main.kicad_pcb]
2020-03-10 Optimize the position of the diodes and the silk screen of row 3 of the left half.
    [left-main.kicad_pcb]
2020-03-10 Tidy up row 3 and 4 of the left half.
    [left-main.kicad_pcb]
2020-03-10 Tidy up row 5 of the left half.
    [left-main.kicad_pcb]
2020-03-10 Reposition left D52.
    [left-main.kicad_pcb]
2020-03-10 Reposition left D42.
    [left-main.kicad_pcb]
2020-03-10 Tidy up row 2 of the left half.
    [left-main.kicad_pcb]
2020-03-10 Tidy up row 1 of the left half.
    [left-main.kicad_pcb]
2020-03-10 Adjust position of left D23.
    [left-main.kicad_pcb]
2020-03-10 Update left SW14.
    [left-main.kicad_pcb]
2020-03-10 Tidy up left row 1.
    [left-main.kicad_pcb]
2020-03-10 Update left SW15 socket.
    [left-main.kicad_pcb]
2020-03-11 Update left SW12 and SW13 and sockets. 3 unconnected items to connect.
    [left-main.kicad_pcb]
2020-03-11 Update right SW27 socket.
    [right-main.kicad_pcb]
2020-03-11 Update right SW54.
    [right-main.kicad_pcb]
2020-03-11 Update right SW56 socket.
    [right-main.kicad_pcb]
2020-03-11 Tidy up row 5 of the right half.
    [right-main.kicad_pcb]
2020-03-11 Tidy up most of the row 4 of the right half.
    [right-main.kicad_pcb]
2020-03-12 Further tidy up silk screen and improve diode placement on the right half.
    [right-main.kicad_pcb]
2020-03-12 Tidy up silk screen and improve diode placement on the right half.
    [right-main.kicad_pcb]
2020-03-12 Reposition right D43.
    [right-main.kicad_pcb]
2020-03-12 Use modules/S01_Hybrid_Socket_2.kicad_mod
    [left-main.kicad_pcb]
2020-03-12 Add more copper near the left pad of SW13 socket of the left half for increased mechanical strength.
    [left-main.kicad_pcb]
2020-03-12 Update left SW12 socket.
    [left-main.kicad_pcb]
2020-03-12 Connect GND all the way on the left half.
    [left-main.kicad_pcb]
2020-03-12 Update the footprint associations of the sockets of the left half.
    [left-main.sch]
2020-03-12 Update the footprint associations of the sockets of the right half.
    [right-main.sch]
2020-03-12 Replace 4.7K resistors with 5.1K
    [right-main.kicad_pcb, right-main.sch]
2020-03-12 Replace 47 ohm resistors with 33 ohm resistors.
    [left-main.kicad_pcb, left-main.sch, right-main.kicad_pcb, right-main.sch]
2020-03-12 Make the silk screen a bit nicer around the left test LED section.
    [left-main.kicad_pcb]
2020-03-12 Connect GND more thoroughly on the left half.
    [left-main.kicad_pcb]
2020-03-12 Connect GND more thoroughly on the right half.
    [right-main.kicad_pcb]
2020-03-12 Move left D37 out of the way of the keepout area.
    [left-main.kicad_pcb]
2020-03-12 Bump version number to 3.2.0
    [display.kicad_pcb, display.sch, left-main.kicad_pcb, left-main.sch, right-main.kicad_pcb, right-main.sch]
2020-03-12 Pour ground over the unfilled areas of the right board.
    [right-main.kicad_pcb]
2020-04-05 Reduce boss hole diameters to 4.85 mm.
    [left-main.kicad_pcb, right-main.kicad_pcb]
2020-04-07 Fix boss hole position.
    [right-main.kicad_pcb]
2020-04-07 Remove cutout near the boss.
    [right-main.kicad_pcb]
2020-04-07 Fix boss distances.
    [left-main.kicad_pcb, right-main.kicad_pcb]
2020-04-07 Update keepout distance positions.
    [left-main.kicad_pcb, right-main.kicad_pcb]
2020-04-07 Fix keepout areas around boss holes.
    [left-main.kicad_pcb, right-main.kicad_pcb]
2020-04-12 Update Omron microswitches so all of their 3 pads are PTH.
    [left-main.kicad_pcb, right-main.kicad_pcb]
2020-04-12 Move via outside of the pad of SW46.
    [left-main.kicad_pcb]
2020-04-13 Switch from 4.7K resistors to 5.1K.
    [left-main.kicad_pcb, left-main.sch, right-main.kicad_pcb, right-main.sch]
2020-04-13 Route the GND of C9 closer to U2.
    [left-main.kicad_pcb]
2020-04-13 Bump version number to 3.3.0
    [display.kicad_pcb, display.sch, left-main.kicad_pcb, left-main.sch, right-main.kicad_pcb, right-main.sch]
2020-04-13 Tweak the routing of the LED_SW3 track to avoid DRC error on the panel.
    [right-main.kicad_pcb]
2020-06-02 Fix the position of the left side pogo pin connector.
    [left-main.kicad_pcb]
2020-06-10 Capitalize UGL library name for the schematic.
    [display.sch]
2020-06-22 Set socket attributes to SMD.
    [left-main.kicad_pcb, right-main.kicad_pcb]
2020-06-22 Use the correct socket types per switch for the right half.
    [right-main.kicad_pcb]
2020-07-04 Update S01_Hybrid_Socket modules on the right half and reroute every net with the exception of 5 nets.
    [right-main.kicad_pcb]
2020-07-04 Fully reroute nets.
    [right-main.kicad_pcb]
2020-07-04 Update S01_Hybrid_Socket sockets on the left half and reroute every but 19 nets.
    [left-main.kicad_pcb]
2020-07-04 15 nets to be rerouted.
    [left-main.kicad_pcb]
2020-07-04 Reroute all but 2 nets.
    [left-main.kicad_pcb]
2020-07-05 Route every net.
    [left-main.kicad_pcb]
2020-07-05 Tweak tracks.
    [left-main.kicad_pcb]
2020-07-05 Update S01_Hybrid_Socket_Inner_Left sockets and reroute affected nets.
    [left-main.kicad_pcb]
2020-07-05 Update S01_Hybrid_Socket_Inner_Right sockets.
    [right-main.kicad_pcb]
2020-07-05 Fix EuroCircuits DRC error by relocating via.
    [left-main.kicad_pcb]
2020-07-05 Update S01_Hybrid_Socket_2 and reroute affected nets.
    [left-main.kicad_pcb]
2020-07-05 Update S01_Hybrid_Socket_Backslash and reroute affected nets.
    [right-main.kicad_pcb]
2020-07-05 Update S01_Hybrid_Socket_Right_Fn and reroute affected tracks.
    [right-main.kicad_pcb]
2020-07-05 Update S01_Hybrid_Socket_ISO_Left socket and affected nets.
    [left-main.kicad_pcb]
2020-07-05 Update S01_Hybrid_Socket_ISO_Middle.
    [left-main.kicad_pcb]
2020-07-05 Update S01_Hybrid_Socket_ISO_Right
    [left-main.kicad_pcb]
2020-07-05 Update S01_Hybrid_Socket_ISO_Left
    [left-main.kicad_pcb]
2020-07-05 Fix DRC error near the ISO left socket.
    [left-main.kicad_pcb]
2020-07-06 Connect shield instead of ground via the spring pad.
    [right-main.kicad_pcb]
2020-07-06 Bump version to 3.4.0
    [display.kicad_pcb, display.sch, left-main.kicad_pcb, left-main.sch, right-main.kicad_pcb, right-main.sch]
2020-07-06 Route GNDPWR farther from the edge of the board.
    [right-main.kicad_pcb]
2020-08-04 Update sockets so that there is no silk screen between their holes.
    [left-main.kicad_pcb, right-main.kicad_pcb]
2020-08-04 Fix the positions of the vias below U1.
    [left-main.kicad_pcb]
2020-08-04 Add part numbers of the 51281-0594 connectors to the silk screen.
    [left-main.kicad_pcb, right-main.kicad_pcb]
2020-08-04 Add USB-C connector part number.
    [right-main.kicad_pcb]
2020-08-04 Add part number for the I2C bus developer header.
    [left-main.kicad_pcb]
2020-08-30 Don't use Protel file extensions.
    [display.kicad_pcb, left-main.kicad_pcb, right-main.kicad_pcb]
2020-08-30 Make optional connectors virtual.
    [left-main.kicad_pcb, right-main.kicad_pcb]
2020-09-13 Align front key texts for improved readability.
    [left-main.kicad_pcb, right-main.kicad_pcb]
2020-09-13 Rename the reference designator of the test LED from D1 to D2.
    [right-main.kicad_pcb, right-main.sch]
2020-09-13 Improve the alignment of back side key texts for better readability.
    [left-main.kicad_pcb, right-main.kicad_pcb]
2020-09-13 Bump version to 3.4.1
    [display.kicad_pcb, display.sch, left-main.kicad_pcb, left-main.sch, right-main.kicad_pcb, right-main.sch]
2020-09-14 Update USB connector and ESD suppressor footprints for better AOI compatibility.
    [left-main.kicad_pcb, right-main.kicad_pcb]
2020-09-14 Update diode silk screen and move closer to the diodes their reference designators.
    [left-main.kicad_pcb, right-main.kicad_pcb]
2020-09-21 Remove unterminated tracks.
    [right-main.kicad_pcb]
2020-09-21 Adjust track near C24 to respect minimum clearance.
    [right-main.kicad_pcb]
2020-09-22 Move D31 away from the keepout area.
    [right-main.kicad_pcb]
2020-09-22 Move D42 away from the keepout area.
    [right-main.kicad_pcb]
2020-09-22 Bump version to 3.5.0
    [display.kicad_pcb, display.sch, left-main.kicad_pcb, left-main.sch, right-main.kicad_pcb, right-main.sch]
